nygma2004/growatt2mqtt/(threads)

Thread 1 (2022-01-17):

only one datapoint is in ioBroker

DraycD, 2022-01-17:
Hi,
first of all thank you for all your work.

i have the issue that in iobroker is only one datapoint were is all in, but not seperate points:
do you have any idea how it can send seperate?
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

nygma2004, 2022-01-25:
I designed it to send all the data into a single topic in JSON format, because it is much easier to process for me rather than having 30 messages all in separate topic. If you want that, you need to re-write the `ReadInputRegisters()` method. There is a section with a comment saying `Generate the modbus MQTT message`. As you can see I put all the data into a JSON there. You can break that up, and send each of them into a separate MQTT topic.
I hope that will be enough, as there will be a lot of MQTT communication done in that method. It may take too long time and the ESP may crash not having enough time to perform other housekeeping tasks.

SHODK, 2022-02-05:
Hi,
What a great project you have made here, I follow you video and think I made a correct setup, however I get Error: Invalid slave ID on the MQTT
My Growatt is smae as yours, MIN 3000TL-XE
I check the COM ID on Growatt it is set to 001
I try change it to 002 or 003 with the same change in Arduino sketch
I double check my wiring of Wemos D1 and TTl to RS-485 module, I have same 230V power supply as you show
No matter what I try it give me same error, do you have any idea where to look?

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

DraycD, 2022-03-04:
I split it now direct in iOBroker.
Is there a Json path in browser?
something like http://192.168.2.43/cm?cmnd=status%208

sorry i m a noob

AlexanderSch90, 2023-03-21:
Hey @DraycD , can you please share your Iobroker code (your javascript; your blockly) to split the json?

hendrikhoffmann, 2024-02-11:
I forked the project and changed the mqtt transfer from json to single data points.
I also added a Webinterface and API for controlling the inverter limits.
see https://github.com/hendrikhoffmann/growatt2mqtt

nygma2004, 2024-02-13:
> I forked the project and changed the mqtt transfer from json to single data points. I also added a Webinterface and API for controlling the inverter limits. see https://github.com/hendrikhoffmann/growatt2mqtt

Thanks for sharing this. Great job!

hoschiking, 2024-08-01:
@hendrikhoffmann
what´s the right way to compile your fork of the project?
the original project growatt2mqtt I compiled and it works fine.
I´m not able to do this.
I have the impression that some code is missing.
Do I have to replace parts of the original code with your code?
It woukd be finem if you would desribe it step by step.
Thank you in advance

hendrikhoffmann, 2024-08-03:
Thanks for letting me know & Fixed.
Either update the project or comment out
//#define useModulPower
in settings.h

hoschiking, 2024-08-08:
Your bugfix is working, now I´m able to compile it. thanks !!!
your fork would be absolutely perfect if the MQTT configuration was not implemented in the code, but could be configured via the Web API. Like with Wifi.
If the environment changes, you have to recompile every time.
It would be fine :-)

Thread 2 (2022-02-05):

Getting Error: Invalid slave ID

SHODK, 2022-02-05:
Hi,
What a great project you have made here, I follow you video and think I made a correct setup, however I get Error: Invalid slave ID on the MQTT
My Growatt is same as yours, MIN 3000TL-XE
I check the COM ID on Growatt it is set to 001
I try change it to 002 or 003 with the same change in Arduino sketch
I double check my wiring of Wemos D1 and TTl to RS-485 module, I have same 230V power supply as you show
No matter what I try it give me same error, do you have any idea where to look?

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

nygma2004, 2022-02-05:
OK, so this is interesting. In the log I can see messages saying that "Data MQTT Sent". So it is able to read data off the inverter from time to time. It is possible that the read rate is too quick for the inverter. That does not explain why it would send and invalid slave ID, but still. Can you change the UPDATE_MODBUS variable from 2 to for example 5 and test again?

SHODK, 2022-02-05:
Thanks for the quick reply, it did not help increasing it to 5 or 10, however I did find the fault and it was my own, when compiling the Arduino sketch a few days ago, it gave an error on "mqtt.setBufferSize(1024)" so I commented it out, it turnout that my PubSubClient library was a old version 2.7.0, upgrading to 2.8.0 it could now compile without error, uploaded program and everything works now.
Again, thanks for a great program and video

nygma2004, 2022-02-06:
Oh, wow, I did not know that the setBufferSize was only implemented in 2.8.0. Good catch. I needed this as the data payloads are very big.

unimatrixZxero, 2022-08-21:
Adding a data-point here. I had that error as well initially, I noticed that one of the connections to the RS485-TTL wasn't very good. Fixed the connection and the issue resolved itself.  Specifically it was the DE -> D5 connection ( RS485-TTL -> ESP32 D1 Mini)

no-Legend, 2023-07-27:
I'm facing the same problem with my MIC600, all the time I got that error.
Allready using the 2.8.0 version of PubSubClient and there is now warning during the compilation.

nygma2004, 2023-07-27:
@no-Legend sorry but to be exact, are you getting the error on compiling the sketch?
Can you paste in the error that you get?

Closed 2022-02-06.

Thread 3 (2022-03-09):

Max485 <----> ESP / IOs are not 5V tollerant

Stumpf74, 2022-03-09:
Hello,

I have a question about the hardware.
you use 5V for your circuit. The ESP generates the 3.3V for the core voltage from this. This means that you would actually need a level shifter between ESP and MAX.

Will it work without one?

Thanks

BR
Stumpf

nygma2004, 2022-03-09:
Yes it certainly works. To be honest I never realized that MAX is 5V. I copied the hardware from another project and used it in many different project, and never had any issues.

Stumpf74, 2022-03-10:
Okay then, I will try this!

Thanks for the project. My Growatt MIN 3600TL-XE I will report briefly on how it works.

Stumpf74, 2022-03-15:
Hello, so it works.

I use the USB connection as the power supply.
This gives me the data I need for my control system.

Thanks for your advance work.

Greetings

Closed 2022-03-15.

Thread 4 (2022-06-14):

Wifi does not connect

Alexbuehs, 2022-06-14:
I am a newcomer to the field, I flashed the ESP with the code via Arduino. I made the setting under Settings.h but unfortunately the ESP does not connect to the Wifi after flashing. Can you maybe help me and tell me where exactly I have to set what in the Settings.h tab?
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

nygma2004, 2022-06-14:
You need to change all the x-es to the actual values in your system: SSID, password, MQTT server IP address, userid and password.

Alexbuehs, 2022-06-14:
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

nygma2004, 2022-06-14:
You can leave it as it is. The ESP will just get a dynamic IP address, it will not impact how it works.

Alexbuehs, 2022-06-14:
First of all, thank you very much for your help. That's exactly how I did it and the esp was flashed without any problems but when I then open the serial monitor there is always WIFI Connecting .............. and that repeats itself again and again. If the esp is flashed, the blue LED also lights up permanently, is that correct?

nygma2004, 2022-06-14:
Yes, the blue is on until it connects to the wifi, and from that point it only flashes when reads the inverter. Can you screenshot the current settings.h file (obviously blurring out the passwords) and the full serial log? Maybe that will give me some ideas on what is going on.

Alexbuehs, 2022-06-14:
I will take a screenshot of settings.h tomorrow and post here. Thanks again for your help.

Alexbuehs, 2022-06-15:
Hey, I realised that the code is running. I deleted your code from the computer again. Then I re-downloaded your code again in Arduino opened the x-es replaced and flashed. The ESP now connects to the Wifi. Now I just have to see that I can do it with the broker. Do that with a raspberry and the iobroker but in the data point it only says true. Is there another way to even see if the esp receives data? I connected all this to a Growatt TL-X.

Alexbuehs, 2022-06-15:
And one more question. Does the Wifi Shine X Stick have to be unplugged?

nygma2004, 2022-06-15:
Check the serial debugger. If it is not able to read the inverter, you get some error messages (like No Response or similar). So if you see no error, the modbus is working.
I think the Shine X plugs into a different port, so you can leave it. I don't have that.

Alexbuehs, 2022-06-15:
How do I get the serial debugger via wifi? Or leave the esp connected to the pc and then via the serial monitor from Arduino?

nygma2004, 2022-06-16:
Yes, use it connected to the computer and user the serial monitor from Arduino IDE.

Closed 2022-06-16.

Thread 5 (2022-07-07):

MQTT data not received from inverter.

Flintebassen, 2022-07-07:
Hi.

Since this morning i only receive data on Growatt/status not on Growatt/data.
I have tried both the 1.2 and 1.3 code.

Maybe it's just my inverter, i dont know.
It have been running fine for 1 month, but stopped this morning.

MQTT explorer also only shows data from Growatt/status.

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

nygma2004, 2022-07-08:
The "Error: Response timed out" is an error message from the modbus communication. For some reason your ESP is no longer talking to the inverter over modbus. I am not sure what the issue can be. I recommend to check the wiring and the connection first. Maybe one of the wires somewhere got loose.
My second guess that the modbus module has died, but it never happened with me so that I think is less likely.
Nevertheless, please use the same firmware that was working before.

Flintebassen, 2022-07-08:
Hi, thank you for getting back to me.
I did not consider wiring because i get the data from Growatt/status fine.
I will check it anyway.

Flintebassen, 2022-07-08:
I have checked the wiring, all ok.
I will try and power down/up the inverter tomorrow.
The problem exist on any of the firmware. I only tried the newest one because the old one did not work anymore.

nygma2004, 2022-07-10:
I am not sure what to say. The client address of the inverter is 1, and I don't think it can even be changed (or how). So I really don't know why it is not communicating. Again, all I can think is that the TTL to RS485 module died.

Flintebassen, 2022-07-14:
You where right. The RS485 adapter was faulty. I replaced it with another brand, and it is working now. Sorry for the confusing.

Closed 2022-07-14.

Thread 7 (2022-08-14):

Publish Home Assistant auto-discovery sensors

That-Dude, 2022-08-14:
First of all I just want to say thank you for this project. I've got it working with my Growatt inverter and learned so much in the process.

I use Home Assistant and the trickiest part was figuring out how to import the values, I achieved this by adding MQTT sensors to my `configuration.yaml` but it's a hacky solution.

```
sensor:
- platform: mqtt
  name: 'Growatt Solarpower'
  state_topic: 'growatt/data'
  value_template: '{{ value_json.solarpower }}'
  unit_of_measurement: 'W'
  device_class: power

- platform: mqtt
  name: 'Growatt Enery Today'
  state_topic: 'growatt/data'
  value_template: '{{ value_json.energytoday }}'
  unit_of_measurement: 'kWh'
  device_class: energy
```

I was wondering if you might add the functionality to publish the sensors from your sketch into the `homeassistant/sensor/growatt' topic, as this would allow Home Assistant auto-discovery:

I borrowed this example from another solution:

```
Topic :homeassistant/sensor/inverter_1_pv_power/config

{"device":{"ids":["sa_inverter"],"mdl":"Growatt MIN/MIC","mf":"Growatt","name":"Growatt MIN/MIC"},"device_class":"power","name":"PV power","state_topic":"solar/inverter_1/pv_power/state","uniq_id":"inverter_1_pv_power","unit_of_measurement":"W"}
```

nygma2004, 2022-08-14:
Hmmm, I have seen these homeassisant topic in my MQTT server, but never really paid much attention to them. But it does not look too complicated. But it will be a hell of a large big configuration message considering the high number of fields. I am in a middle of a large project, but I have some tidy up work to do here, so I think I will come back to this somewhere during the fall and add the homeassistant part as well.

That-Dude, 2022-08-16:
ok that sounds great, I'm looking forward to seeing the results.

I'm super pleased with your sketch, it's been working flawlessly for a week now.

nikito7, 2022-09-13:
For large configurations yaml it's easier to manage

jtauscher, 2023-01-26:
> For large configurations yaml it's easier to manage.
>
> One advantage of discovery, it's create a device on HA

> For large configurations yaml it's easier to manage.
>
> One advantage of discovery, it's create a device on HA

Hi nikito7, can you please explain how it works? Do you maybe have an example yaml code?

nikito7, 2023-01-26:
https://github.com/nikito7/easyhan/blob/dev/growatt/pv1-discovery.txt

Thread 8 (2022-08-17):

Used housing?

no-Legend, 2022-08-17:
Can you tell us which housing you designed the pub for?

Cheers Robert

nygma2004, 2022-08-17:
Sorry, I don't get it. Pub?

unimatrixZxero, 2022-08-21:
I think the question is asking. "What housing did you use to put the PCB in?" Or, what's the housing you used to put the components in?

nygma2004, 2022-08-23:
I used a regular electrical box I could find in my local shop. This is one of the harder shell models. I cut an opening on the top and added a window with a piece of acrylic.
I think it was this: https://daniella.hu/sez-kotodoboz-s-box-216-sima-falu-120x80x50-id-sez1001081000
It is hard to find transparent top enclosures.

Closed 2023-03-05.

Thread 10 (2022-09-24):

esphome has an Growatt component which could use your enhancement

osos, 2022-09-24:
Just wanted to make you aware that esphome has a preliminary growatt component.

https://esphome.io/components/sensor/growatt_solar.html
https://github.com/esphome/esphome/tree/dev/esphome/components/growatt_solar

Maybe it would be even easier to maintain etc to enhance the esphome component with the communications you have made here.

I think that would be a good place to merge the project as that will make it easily availble to the arduino/home-assistant community.

nygma2004, 2022-09-25:
Well, it looks like ESPHome implemented the same what I did. To be honest, I don't see a point merging anything. If you are using home assistant just set up ESPHome and for pure MQTT one can use my project.

Closed 2023-03-05.

Thread 12 (2022-10-23):

Spf5000es?

Roadkill69, 2022-10-23:
Howzit man, nice project,

I have been trying to get an esp working with an spf5000es, the comm port is a usb type A which connects to the dongle. Check the thread below, others have managed to flash the dongle (which has an esp chip) and use with esphome.

Any ideas on how to get Comms with this from the usb A port and an esp32, possible wiring?

https://community.home-assistant.io/t/esphome-modbus-growatt-shinewifi-s/369171/51

nygma2004, 2022-10-23:
Well, SPF5000ES looks like a nice inverter. I like that it can also use lead acid batteries, not just Litium.
Anyway, within the thread they mention that the Shine Wifi dongle uses GPIO 1 and 3.
So in the settings.h you can define it here:
#define MAX485_RX       14        // D5, RO pin on the TTL to RS485 converter
#define MAX485_TX       12        // D6, DI pin on the TTL to RS485 converter
so instead of 14 and 12 it should be 1 and 3. I can never tell which one should be which so you have to try.

I also had a quick look at the documentation and it looks like you have an RJ45 plug and that is the modbus connection on that inverter. So you can use that as well.

Thread 16 (2023-01-28):

use  growatt2mqtt  on classic arduino

geimel, 2023-01-28:
Hi,
I've found your great project and will use a part of your code on a arduino nano, to display the data on a oled display.
Yesterday I've received my MIC 1500TL-X, I have connected the RS485A1 and B1 to an usb-rs485 convertert, I've send several requests (read input an holding register) but get absolutely no answer.
Is it possible to help me with an example complete modbius request message, so I can send this over a terminal an check the connection.
(the RS485A2 B2 port works well, here I can see the requests of the inverter to smartmeter after activating this, so I think the USB Converter works)
Thanks a lot
Richard

nygma2004, 2023-01-28:
OK, so you have connected the inverter with your laptop with a usb-rs485? What program do you use to read data? What do you mean that you get nothing?

geimel, 2023-01-29:
there is no response from the MIC when I send a query

nygma2004, 2023-01-29:
Well, it is hard to tell from here. Few obvious questions:
- MIC is running/powered?
- Did you set the communication to 9600 baud, 8, N, 1? Slave ID = 1? Did you pick the correct COM port?
- Try swapping the A and B wires
- The USB and serial is close to the inverter?
- You are reading input registers, right?
- You are reading a few, like address 0 quantity 5?

geimel, 2023-01-30:
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

All above = yes.
I think it is a hardware defect :-(

nygma2004, 2023-01-31:
That is also possible. It would be a good idea to test with another USB to RS485 adapter.

Thread 17 (2023-02-10):

Schematic

bennybubble, 2023-02-10:
Hi,

Can you publish the schematic diagram of the interconnects ?

Thans in advance!

nygma2004, 2023-02-10:
Sorry, which interconnects?

bennybubble, 2023-02-10:
Between Wemos / RS485 / LED

bennybubble, 2023-02-10:
Sri, just found them in settings.h ... :-)

Closed 2023-02-10.

Thread 22 (2023-03-18):

RS232 Viability

chromos33, 2023-03-18:
Let me preface this with saying I am an absolute beginner on arduino etc. (webdeveloper with some c# experience)

But would it be possible to adapt this library to use this over the usb connection on the MIC 600 TL-X or do I need the RS485 cable connection?

And with the RS485 would I use the COM port as I don't see a "Sys Com" port on the inverter.

As far as I can google the usb is apparently just an RS232 wrapper.

chromos33, 2023-03-18:
nvm figured it out by referencing https://github.com/Lyve1981/GrowattUsbModbus
just need to replace the conents of growattInterface.cpp growattIF::initGrowatt()
with
Serial.begin(115200);
  growattInterface.begin(SLAVE_ID , Serial);

  static growattIF* obj = this;

nygma2004, 2023-03-19:
Sorry the late response. I am glad you managed to figure it out, because honestly I would have no idea how to do this. Kudos.

Closed 2023-03-18.

Thread 24 (2023-04-03):

SOC data request

aherzer69, 2023-04-03:
Hello,
first at all...THANK YOU VERY MUCH TO CREATE SUCH A GREAT PROJECT!!!!
Now I am trying to implement additional data from "Growatt Inverter Modbus RTU Protocol":
https://www.photovoltaikforum.com/core/attachment/265072-pdfcoffee-com-growatt-inverter-modbus-rtu-protocolii-v120-english-pdf-free-pdf/
(I think this is the right protocol for my SPH4600 because values until "95" (tempboost) are ok)

To get the SOC I add to your "growattInterface.cpp":

`    if (setcounter == 15) {
      // Battery
      modbusdata.socinverter = growattInterface.getResponseBuffer(1014 - 960);
    }`

and below the section:

 `setcounter++;
    if (setcounter == 2) {
      setcounter = 0;
      // Generate the modbus MQTT message
      sprintf(json, "{", json);
      sprintf(json, "%s \"status\":%d,", json, modbusdata.status);
      sprintf(json, "%s \"socinverter\":%.1f,", json, modbusdata.socinverter);`

In "growattInterface.h" I added to section the "socinverter":
`    struct modbus_input_registers
    {
      int status;
      float solarpower, pv1voltage, pv1current, pv1power, pv2voltage, pv2current, pv2power, outputpower, gridfrequency, gridvoltage;
      float energytoday, energytotal, totalworktime, allphaseenergy, gridpowertolocalload, energyp3, pv1energytoday, pv1energytotal, pv2energytoday, pv2energytotal, opfullpower;
      float dischargepower, chargepower, socinverter, batsoc;
      float tempinverter, tempipm, tempboost;
      int ipf, realoppercent, deratingmode, faultcode, faultbitcode, warningbitcode;
    };`

As MQTT feedback I received a "0" :-(
("socinverter": 0)

Did I something wrong to define "setcounter"???

nygma2004, 2023-04-05:
OK, so you need to read all the way up to 15*45 registers to get the battery soc.
Your approach is correct, but I think you made a mistake here:
```
      setcounter++;
      if (setcounter==2) {
        setcounter = 0;
```
Here, this code resets the setcounter to 0 after 1. Because I only needed to read 2 sets of 45 registers. So for you, you need to allow the code to count all the way up to 16 sets to reset.
````
      setcounter++;
      if (setcounter==16) {
        setcounter = 0;
````
I think that should work. Please give it a try, I can obviously not test that.

Thread 25 (2023-04-07):

Use growatt2mqtt for evcc

aherzer69, 2023-04-07:
Hello,

I would like to use the data from growatt2mqtt for EVCC

EVCC propsed following for Growatt inverter:
([https://docs.evcc.io/docs/devices/meters](url))

`meters:
  - name: my_grid
    type: template
    template: growatt-hybrid
    usage: grid

    # RS485 via adapter (Modbus RTU)
    modbus: rs485serial
    id: 1
    device: /dev/ttyUSB0 # USB-RS485 Adapter Adresse
    baudrate: 9600 # Prüfe die Geräteeinstellungen, typische Werte sind 9600, 19200, 38400, 57600, 115200
    comset: "8N1" # Kommunikationsparameter für den Adapter

    # RS485 via TCP/IP (Modbus RTU)
    modbus: rs485tcpip
    id: 1
    host: 192.0.2.2 # Hostname
    port: 502 # Port

    # Modbus TCP
    modbus: tcpip
    id: 1
    host: 192.0.2.2 # Hostname
    port: 502 # Port`

Is it possible to implement here the growatt2mqtt data?

or

I found also an older generic format of evcc:

`meters:
  - name: my_solarlog
    type: custom
    power:
      source: calc
      add:
        - source: modbus
          uri: 192.168.0.77:502
          id: 1
          register:
            address: 3502
            type: input
            decode: uint32s
          scale: -1`

As I understood, this is refering directly to modbus data.?
But I don't know how to use.
Is the "uri" the IP of my Inverter or from D1-mini with growatt2mqtt?
"id" = ?
"address" = modbus id of Growatt protocol? ("1" for "Input power (high)", ...)

I am sure it is possible, but I was not able to solve.

nygma2004, 2023-04-07:
OK, after reading about this page for 15-20 minutes, it looks like this software can read modbus directly. Ideally you don't even need my converter at all. You can plug an RS485 to USB converter into the computer/SBC this software is running on and connect the A/B lines to Growatt directly. And it will read the data straight from the inverter. You can see Growatt examples in their page. Remember RS485 can travel few hundred meters without any problems.

Or you can get a modbus RS485 to TCP gateway, and use the TCP example. I would try either of these routes and it will be a direct communication between evcc and the inverter.

As far as I can see, these examples support some generic Growatt Hybrid inverter and TL-XH series, so if you have one of those it will work. But they don't seem to have a template for other models.

aherzer69, 2023-04-08:
Thank you very much for effort and quick reply!!!
I am very happy with your software! It is running since weeks w/o problems.
With your software I have robust values (just in time!) to use it for my Home Assistant activities.
If it is not possible to use the access of growatt2mqtt to evcc, I will try to use the mqtt data in evcc.

nygma2004, 2023-04-09:
I don't think it is possible. I have seen modbus client implementation for the ESP, but a modbus master.
The only option I can think about is a modbus RS485 to TCP gateway and through that evcc and homeassistant could read your inverter as well.

Thread 26 (2023-04-10):

WDT Timeout Issue

cwynd, 2023-04-10:
Congrats on a nice project!
I am trying to port the code to a ESP32C3 (I have a few, and I've used them in several other projects), and I've commented pretty much everything except the core functionality (no ArduinoOTA, no NeoPixel, no MQTT data send), just some `Serial.println()` debug messages for now.

I'm trying to talk to one (of a pair) of Growatt SPF3000TL inverters.
But if I flash the code (stripped down as above) I get "Guru Meditation Error: Core  0 panic'ed (Interrupt wdt timeout on CPU0)." (error repeated verbatim for future searches). I noticed you mentioned a WDT timeout in one of the videos, which got my attention, so hoping you may have some more insights.

My Timer ISR (same as your master code) calls `ReadHoldingRegisters()` in the ino, which invokes `growattInterface.ReadHoldingRegisters(json)` in growattInterface, of which the relevant entry point is:
```
uint8_t growattIF::ReadHoldingRegisters(char* json) {
  uint8_t result;
  ITimer0.stopTimer();
  result = growattInterface.readHoldingRegisters(setcounter * 64, 64); //<< WDT panic is occurring here
  // result = 0;
  ITimer0.restartTimer();
```
If I comment the `readHoldingRegisters` line and uncomment the `result=0;` it runs fine.
 Of course there could be several reasons something is timing out there - communications problem with the TTL to RS485 board (mine looks identical to the one you used), failed communications with the Growatt, etc, etc.

I would really like to drill down in to the `growattInterface.readHoldingRegisters(setcounter * 64, 64)` call to try and figure out in more detail exactly what is timing out, so I can narrow it down, but I'm lost in the overloading of `ReadHoldingRegisters` (either capitalized or not) in the ino, and also in the growattInterface class.
So a specific question: where do I find the code that `growattInterface.readHoldingRegisters(setcounter * 64, 64)` invokes? grep etc is not helping.

I really like the clean ISR approach to invoking the code, but I'm stuck trying to use it at the moment.
Any insights really appreciated!

cwynd, 2023-04-11:
Thanks, it's a good point, the `ITimer0.stopTimer()` in my code only stops that specific ISR from getting double triggered if it takes too long. But rereading your code, I see that you turned off the interrupt WDT itself. I may have to try that on the ESP32C3, but it may be problematical with other timing critical things going on.

Where's the source for the `growattInterface.readHoldingRegisters(setcounter * 64, 64)` method?
I must be missing something, I can't find it.

On a very rough guesstimate the Growatt modbus dialog must take something like 500mS (64 x 16 bit registers @ 9600, ignoring overhead), so we're looking for relatively a lot of time.

Thanks again

cwynd, 2023-04-13:
I've been able to get past the WDT timeout issue by refactoring the code as a couple of [Tasks](https://www.freertos.org/implementing-a-FreeRTOS-task.html) on top of the Espressif FreeRTOS core, and I'm using a queue to pass the json from a Growatt Modbus query task to an MQTT post task.

This seems fine so far, and solves the WDT timeout issue, without having to disable the WDT. These tasks run at a lower priority than core processes (WDT etc), and so can take as long as they need. This means though the Modbus code may get interrupted by the core intermittently, so a concern is that this may trip up the serial timing, though I have not seen evidence of that yet, and since it's only 9600 there's hope that it won't.
I believe all Espressif SoCs (ESP...) use their version of FreeRTOS under the hood, so this approach _might_ be applicable to the ESP8266 as well.

How did you figure out the `SLAVE_ID` of the Growatt?
I am now getting `Invalid SlaveID` back from the Modbus code, and with weak documentation struggling to figure out the valid slave ID, short of taking the time to brute force it.

nygma2004, 2023-04-14:
The default slave ID is 1. But you can change it on the screen. I checked the documentation, it does not mention "modbus" or "slave id" anywhere, but this is the closest setting I could find:
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

cwynd, 2023-04-14:
Thanks so much.
I added temporary `Serial.println()`'s for the slaveID that I query and the slave ID sent back from the Growatt in ModbusMaster, and I am getting a _changing_ ID back - on one one occasion I sent 1 and I actually got slaveID 1 back, but on every other occasion I've gotten 2, 3, etc.

So I'm now thinking that the serial comms is not working the way I think it's working for whatever reason (timing inside the FreeRTOS Task?).
I've ordered an RS485 to USB dongle, and I'll try talking to the Growatt using [mbpoll](https://github.com/epsilonrt/mbpoll) from my laptop. This should remove at least some of the uncertainty around new code, comms, etc. leaving only the Growatt talking to known code.

nygma2004, 2023-04-16:
That is very interesting. There is CRC check in the modbus communication, so if the serial data is off, the CRC check would fail and the code would give an invalid CRC error. But checking with mbpoll and a USB dongle is a good workaround to check what is wrong.

cwynd, 2023-04-17:
It's a good point about the CRC check. I've now had a chance to try the USB dongle, and interestingly I am getting almost identical behavior. So this says to me that at least the immediate problem is not in the code, it is somewhere else (although there are few other things to suspect!).

I do wonder whether 9600 is the correct speed - I know in the master code you commented "do not change", but I'm running out of things to suspect now.

Rather than load up this thread with posts not directly related to the subject code, I have posted a question [over here](https://www.reddit.com/r/SolarDIY/comments/12pskpc/growatt_spf3000tl_and_rs485_data/).
I won't close this thread yet, pending any learnings from the post linked above, which may help others with implementing the code.

nygma2004, 2023-04-19:
Thanks, weird. Please let me know if you find out the solution. I see no reason why Growatt would do it any other way, but is it possible that the communication is not Modbus? When I see RS485 I always assume Modbus, but it does not necessarily have to be (sorry did not read the entire documentation). Also try using different flow control, like not 8 bits, maybe change the stop bit and parity. And yes you can play around with the baud as well.

cwynd, 2023-04-19:
So I figured out the communications.

It seems this Growatt SPF3000TL inverter has to be cold-rebooted when the RS485 Modbus slave ID is updated, otherwise it looks like it _listens_ for the new address, but responds with the _old_ address in the header, resulting in the Modbus master seeing an invalid slave ID. My inverters are in a production setting already, and so I had avoided rebooting them until now.

Also, it was a good suggestion to look at flow control, stop bit, parity etc - I had assumed (my bad) that 8N1 was the default, but it is not the default for `mbpoll` and it looks like the CRC errors were caused by a serial protocol mismatch.

I've now got far enough that I have read registers back from my Tasks version of the project code and `Serial.println`-ed the json. So I am moving on to passing the json to the MQTT posting Task, and tidying everything up now.

Thanks again for helpful suggestions!

nygma2004, 2023-04-20:
Wonderful, I am glad that all this worked out. Never thought about the cold-boot issue, good catch.

cwynd, 2023-04-21:
Thanks. I was considering whether to generate a PR for this, but the problem is the ESP32 code ends up being pretty different (HardwareSerial, task-based code structure), and when I tried, I ended up adding many compiler switches, so I don't think it's helpful.
But having said that, suggestions welcome.

Closed 2023-04-19.

Thread 27 (2023-04-16):

Growatt MOD 6000TL3-X

Teppis88, 2023-04-16:
Have to say that this code works fine with this 6kw 3phase model. Only problem is that I can't get voltages from different phases.

Can I somehow scan all the messages that growat sends so I could check em if it sends them?

nygma2004, 2023-04-16:
Yes you can. To make your life easier, maybe you can get a RS485 to USB dongle and you can access modbus directly on your laptop. It is easier to change the modbus parameters in a modbus tester program like Modbus Poll than changing the code, compile and upload. Just like other voltages, the voltage is stored on 0.1V, so you should look for values in 2200-2500 range.

joe288, 2023-04-22:
You can query additional values   in the **growattInterface.cpp** in the **ReadInputRegisters()** function.
As an example you can see how **gridvoltage** is implemented.

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

I think the values   you should be interested in are in the area.
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

You have to test the value of the information that interests you.

Unfortunately, I only have the single-phase version and can't do it for you.

joe288, 2023-04-29:
see changes from here https://github.com/wroadd/growatt2mqtt_for3phases

Teppis88, 2023-05-01:
Thanks Joe288! That works :)

Closed 2023-05-01.

Thread 28 (2023-04-21):

Sending setMaxOutput to MQTT

sstolk90, 2023-04-21:
Hi,

I would like to try this setting to reduce the power of the inverter in case of a negative energyprice when my battery is full.
In MQTT Explorer I tried to send this:

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

What am I doing wrong?
What is the syntax for the MQTT message?
I can not find any documentation in the code.

nygma2004, 2023-04-21:
Let me add @joe288 as he added this functionality to my original code.

sstolk90, 2023-04-21:
Since when is this in the code?
Because I think it's not in mine...

joe288, 2023-04-22:
Hello,
the value is simply transferred in decimal.
From 1-100%.
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
You can also switch off the Growatt completely via setEnable.
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

sstolk90, 2023-04-22:
Like this:
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
I get not any confirmation and the Growatt is still producing more then the limit.
Is this implemented after 20 aug 2022?

joe288, 2023-04-22:
this was added to the master branch of nygma2004 on 10 December.
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

sstolk90, 2023-04-23:
Thanks! So it is not in my sketch yet and that's why it won't scale down when instructed to.
I cannot update the sketch since Arduino IDE is bugging me big time but that is not part of this issue.
I get lots of errors for a FastLED and a lot more of definitions from certain files he cannot find.

Issue can be closed and thanks for your help!

Closed 2023-04-23.

Thread 29 (2023-05-11):

my version

Performance20, 2023-05-11:
Hi,

I forked your software and made some changes. I saw your comments, if stabillity is no so good and OTA firmware update not working
- I migrated to platformio/VSC
- change the string handling which add control of the size of the used buffer (e.g. sprinf to snprintf), which avoid buffer overruns. And there was realy 1 value which was one letter to long for the used buffer. Also using the same buffer as input and output in sprinf funktion could work but the statement is here "behavior not defined". Therfore I changed it.
- Also I removed all this MQTT building code out of the timer funktion. I thing, interrupt routines should be short and fast as possible and not lead to cascading of interrupts
- I added one feature. Now it is possible to change the update times for sending the MQTT messages (original fix values in the code via #defines). Now changeable via MQTT messages and stored in the EEprom of the ESP.
- and some other smaller changes
- But I removed all this RGB led stuff

I have tested it with my Growatt, run fine, Firmware update via OTA works fine well.

Helge

nygma2004, 2023-05-14:
Hi Helge,

Thanks a lot for your work. I know I should really switch from the Arduino IDE to VSC. Everyone says that it is so much better. But I think what would be even more helpful for the community if I would add WifiManager, so I can offer a binary that can be easily flashed to an ESP and WifiManager can be used to configure the server and modbus settings.

I have to be honest, I don't quite understand the importance between sprinf and snprintf, but I will investigate and learn about this more.
Moving most of the code out of the timer callback is a good idea. I was concerned in the beginning that it will cause issues with watchdog timer or something, but since it ended up working, I did not bother to review it.
Setting the refresh interval via MQTT is also a nice feature, and the RGB if only secondary for the entire function of the code, so not important.

I will share you project on my main page.

Regards,
Csongor

Performance20, 2023-05-26:
Short update from my site:
I removed the hard coded Wifi credentials from the code and inplemented a captive portal by using ESPConnect lib.
If the ESP is not configured to Wifi, he starts in AP mode and provide such a web portal, where the SSID can be selected and passeword enterd. Credential will be stored in eeprom.

Regards

Helge

Diddlik, 2023-05-26:
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

Is it possible to move mqtt setup in web settings too?

Thread 31 (2023-05-26):

Smart Meter emulation ingtegration

Diddlik, 2023-05-26:
Hi guys, since begin the use of Growatt I have built myself a small USB dongle to read growatt (https://github.com/Diddlik/USB_Dongle_ESP8266_Max485).
Now I plan to install export limit as well. A good project is here: https://github.com/alessandromatera/SDM230-emulator-growatt-esp-mqtt

What I want to achieve is that I have a stick, an ESP, which is connected to two RS485 converters.
One is used to read Growatt (pin 3/4) and the other Converter would be connected to pin 7/8 to act as a smart meter.
Is it possible to combine the Code of alessandromatera and yours?

The development of hardware part seems to be an easy step, but software part imho not so easy...

nygma2004, 2023-05-30:
As long as Growatt and the smart meter use the same communication speed and settings (9600, 8, 1, N) and the two devices are set to different slave ID, it should work. I would reassign either Growatt or the smart meter from the default slave ID of 1 (I presume) to a different address. And you just need to read / write the smart meter and Growatt after each other. The current Growatt logic already has the SetMaxOutput implemented.

But looking at the alessandromatera code, it does not talk to a Modbus smart meter, but it uses a Shelly smart meter and reads the data over MQTT. So it is not exactly doing what you plan to implement.

Diddlik, 2023-05-30:
> As long as Growatt and the smart meter use the same communication speed and settings (9600, 8, 1, N) and the two devices are set to different slave ID, it should work. I would reassign either Growatt or the smart meter from the default slave ID of 1 (I presume) to a different address. And you just need to read / write the smart meter and Growatt after each other. The current Growatt logic already has the SetMaxOutput implemented.
>
> But looking at the alessandromatera code, it does not talk to a Modbus smart meter, but it uses a Shelly smart meter and reads the data over MQTT. So it is not exactly doing what you plan to implement.

I am a little afraid that SetMaxOutput write to EPPROM from the inverter, which is not good in due long term.
The connection with second RS485 as smart meter solves the problem, because inverter dynamically controls it by itself without writing it to flash every time. or have I thought wrong here?

nygma2004, 2023-05-31:
Possible, but I have no way of telling how the inverter works internally. But both sketches write to the modbus register, therefore I don't see how the SetMaxOutput in our code and the same modbus code in alessandromatera example would be any different.

Thread 32 (2023-06-05):

Growatt MIN 3600TL-XE ?

newegnaro, 2023-06-05:
Hello,
Thank you for sharing this project. I recently has a solar system installed with the above Growatt inverter and I'm trying to get basic data from it into Home Assistant (HA). I've tried some of the HA integrations that pull from the Growatt server but these suffer from being blocked. So I thought I might be able to pull the data from the Modbus registers.

Your project looks like it could work if I pull the data from MQTT, however the SYS-COM definitions in the manual for my inverter  differs from the one you show. (see following image of manual)
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
Do you think it might work ? which of the ports from sys-com should I use ?
Sorry for the simple questions, very much of this is new to me.

nygma2004, 2023-06-07:
I think the smart meter connection is used to connect a meter so the inverter can limit the production to match your consumption (not to sell electricity to the grid). So it is definitely not that one.
I think it should be a the Connect Min ShineBus connection.

newegnaro, 2023-06-07:
Thank you for your thoughts. I need to decide if I have the skill to solder up your project to try this way. OI have been prototyping via a breadboard and ESPhome... but no luck yet.

newegnaro, 2023-06-20:
Hello, thank you for pointing this out. This was the thread i was using for my breadboard example but no luck despite trying a few of the code samples. I might have to try the flashed standard dongle method. Which inverter do you have please ?

nygma2004, 2023-06-20:
I have a 6 year old 3000-TL, and I also have a MIN 3000 TL-XE and MIC 1500 TL-X. The MIN and MIC models have the same connector (as documented in this project), the older 3000-TL has an old style 9 pin D-SUB9 connector.

Thread 33 (2023-09-24):

is it possible to enable/disable and change export limits via modbus for mic type inverters

HenrikRolandHansen, 2023-09-24:
Is it possible to enable/disable and change export limits via modbus for mic type inverters. seams not possible ?

joe288, 2024-03-21:
Hi,
Yes, it is possible to control the inverter so that no electricity flows into the power grid.

You can use the setMaxOutput function to limit the percentage output of the inverter if too much current flows into the grid.
This is nothing other than what is done via the Growat's electricity meter interface.

I would like to integrate this function myself, but unfortunately I am not yet able to read the electricity meter.

Thread 34 (2023-11-13):

Used your code! Thanks! Reworked main as code seems to freeze

matthijsfh, 2023-11-13:
Sorry, no way to contact you directly except via a issue ticket ;-)
Thanks for reverse engineering the inverter. Works like a charm.

However the "main" code seems to freeze.

* I think  **while (!mqtt.connected())** is the root cause if the wifi is lost after the last wifi check. This code will never exit the loop, as the mqtt will not connect, because the wifi is lost.

* Added all relevant parameters to the wifi manager (when then saves them to flash). Having to re-compile to change mqtt server settings is not my preferred solution. I have had issues with this on another ESP project. After 3+ years a mod was needed, and it did not compile anymore due to "progress" in the development tools.

* Added jumper to force the wifimanager to show.

* Added a FAN to cool the inverter which uses the temperature from the electronics board inside the inverter to switch on/off.

Can send you my changes if you are interested.

Greetings Matthijs

nygma2004, 2023-11-14:
Hi Matthijs,

Oh, these are great changes. I am still using my much older version of the code before it got re-worked by Joe. Wifimanager is great, actually I should add it to more of my projects. This also means that we can also offer complied binaries to users which is much easier to flash than if you have to build it yourself.
Good catch on the mqtt.connected issue. I never noticed this problem, I shall look at my version if I had done something differently. A few months ago my laptop died and I have not installed the IDE on my new device (was not working on project recently).
The jumper for the wifimanager is also a good idea. These sequence issues are a real pain to find, mostly because you cannot think of all these cases until it happens. Nowadays I am batteling with some modbus issues between my Node-Red and PLC which all of sudden started happening a few days ago. No software changes, nothing.
Fan is also a great idea.
I am interested in your implementation. If you send it, can you also send me a photo how the jumpe and the fan connection is implemented. I will add them to the readme for others to use it as an example.

matthijsfh, 2023-11-14:
Hi,

I will share my code with you. Think I found your email somewhere ;-)
My growatt code is stored my private github with much more projects.

Did remove some of your features, because I did not want to damage my inverter by sending some commands to it.

Anyway, have a look and maybe you can use some features of it.

Greetings Matthijs

Thread 35 (2023-11-18):

"PV energy today" and PV energy total missmatch

Kletternaut, 2023-11-18:
Hi Csongor,
at first i want to thank you very much, for your work here and also on Youtube. I'm on of your subscriber and have to say, i have learned a ton from what you doing and explaining... in an age of >55 ;-) Thank you man!

So now, i want to inform you there is a register mismatch and failure in the code For MIC-TL-X.

I do not get total- or today-energy values in mosquitto or influx. I've checked the register with the [Growatt Inverter Modbus RTU Protocol V.1.2](https://github.com/nygma2004/growatt2mqtt/blob/main/Growatt%20PV%20Inverter%20Modbus%20RS485%20RTU%20Protocol%20v120.pdf) and it says on the very first page:

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

So, there is **no input** register type range (**04**)  **0 - 124** in the **MIC TL-X** devices, only **3000-3124** also **not even** the (04) 3125-3249 range like the manual says.

your code: growattinterface.cpp:

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

The Growatt RTU Protocol Description for MIC-TL-X input (04) registers says:

**3053** | Epv_total H | PV energy **total**
3054 | Epv_total L  | PV energy total
**3055** | Epv1_today H  | PV1 energy **today**
3056 | Epv1_today L  | PV1 energy today
**3057** | Epv1_total H  | PV1 energy **total**
3058 | Epv1_total L   | PV1 energy total

Could you maybe check and correct this?

Greetings from Karlsruhe/Germany
Tom

nygma2004, 2023-11-18:
Hi Tom,

I also have a MIC-TL-X and the code works just fine there. There is a naming convention in modbus that the input registers are always number from 3000 and the holding registers from 4000 (or the other way around, I can never remember). This is done so when you look at the number you can immediately tell if it is a holding or input register. But in all the modbus software I used and also in the arduino library, you provide the address from the base 3000 or 4000. So what is addres 3000 in the documentation, in the program that is zero.
As I said this code is reading my small MIC 750 and it is fine.

Kletternaut, 2023-11-18:
What you write makes perfect sense, but various totay and total values are still mixed up. Take a look above.
What irritates me now is that I can read out the total and today data via the 3049 with my own nodered flow (attachment) over an waveshare modbus-wlan converter. But not with this esp-script and your Grafana dashboard. All other data are coming in.
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

Kletternaut, 2023-11-18:
I have checked the mqtt-mousquitto log file. `{"fields":{"deratingmode":0,"energytoday":0,"energytotal":0.9,"faultbitcode":0,"faultcode":0,"gridfrequency":49.99,"gridvoltage":227.2,"ipf":20000,"opfullpowe
r":0,"outputpower":21.5,"pv1current":0.3,"pv1energytoday":0,"pv1energytotal":0.9,"pv1power":22.1,"pv1voltage":58,"pv2current":0,"pv2energytoday":0,"pv2energyt
otal":0,"pv2power":0,"pv2voltage":0,"realoppercent":0,"solarpower":22.1,"status":1,"tempboost":0,"tempinverter":26.5,"tempipm":26.5,"totalworktime":165833.5,"
warningbitcode":0},"name":"mqtt_consumer","tags":{"host":"raspberrypi","topic":"growatt600/data"},"timestamp":1700298901}
`
Any ideas?

Kletternaut, 2023-11-19:
Hi Csongor,
i have checked it now multiple times. I am very sorry, also because i know that you have much more knowledge of the matter than i do. I have to say your code is not using the correct registers for the TL-X Series, because you've used the wrong register list documentation.
>There is a naming convention in modbus that the input registers are always number from 3000 and the holding registers from 4000

I noticed this for some manufactures (i believe the Eastron SDM630/230) with 3000x (for holding) and 4000x (for input), but now after my review i know it has nothing to do with this. These in the docmantation described 3000-registers are the right, real and only ones that worked correctly. You can't use register 0001 from a other device alternatively to the 3001 and so on. It is different address with different values in it, even when you get some values out of it and even many of them seems to be the right ones.

The documenatation (site no: 48) says it very clear: The input register for TL-X begins at 3000-3124, (3125...  right after the heading information:
>**Use for TL-X and TL-XH**
and this means **do not start at site no: 33 with input register no: 0.** of an different device.  In many cases the register are kind identical, but a few are different and others do not even exists. If you use 0001 it will bemapped to 3001 or vice versa.

I say it again: there are no input-register 0-124 for MIC-TL-X described in the documentation.

One example (then i'm done here):
In growattInterface.cpp @line 82:

>modbusdata.pv1energytoday = ((growattInterface.getResponseBuffer(59) << 16) | growattInterface.getResponseBuffer(60)) * 0.1;

Here you want to get value of "energy PV1 of actual day", like it is described in input-register list no. 59, right? But instead it reads (with, or without the internal mapping function) the register 3059 | E**pv2**_today. There is no PV**2** in a MIC-TL-X. And that is the reason why i am getting no value.  I've found a few other mismatched addresses in your code. No question, it is a total mess what they have done in this documantation.

nygma2004, 2023-11-21:
OK, I see the problem. The issue is that it will be very difficult to make code changes without having the actual device and testing how it works. Also I am not really sure what is the best way of making the code work for the "old" devices and the MIC-TL-X as well. Maybe this new mapping is something they will roll out for all new models in the future?

Kletternaut, 2023-11-21:
i have you send an email

Thread 36 (2023-12-29):

Monitor multiple inverters? Multi-phase, parallel installation.

RoganDawes, 2023-12-29:
I am trying to help a friend monitor his inverters (5 x SPF5000TL HVM-P, arranged as 2 each in parallel on phase A and B, and 1 on phase C) and batteries (4 x Narada 48NPFC100). He has no ShineWifi dongles - apparently these inverters make use of the ShineWifi-F model, which talks RS232 over the USB D+ and D- lines of the USB-A connector.

I have been able to create an ESP32-based device with an SP3232 RS232 transceiver that can talk to one inverter via the USB-A connector. Now I am trying to figure out how best to communicate with the remaining inverters, and the batteries.

With the RS232 connection to a single inverter, and trying to brute force enumerate modbus slave addresses, I was able to find 1 (expected), and 17. I was wondering whether 17 would be the paralleled inverter, 17 == 16+1 or 0b1001, but the readings I got from address 17 were totally inconsistent with the readings from address 1. Lots of 65536 values. Anyone have any idea what might be at address 17?

I'm totally open to switching over to RS485 if it will make life easier in any way. That said, all I have read in the Growatt manuals has not provided any way of changing the modbus slave address from the default 1, which would mean that I would need a RS485 bus for each inverter regardless, to avoid conflict. In which case, since the RS232 transceiver chip I am using has two channels already, and the ESP32 can support up to 3 UARTs simultaneously, I could just use one ESP32 per phase to talk to two inverters, and add an RS485 transceiver to the C-phase ESP32 to talk to the batteries. That said, is it even necessary to query the paralleled inverter, should the readings not theoretically be the same as the primary?

Any other suggestions?

RoganDawes, 2023-12-29:
I did find a mostly unintelligible description of setting the RS485 address on the last page of this document: https://watts247.com/manuals/gw/GrowattModBusProtocol.pdf

> Knock the pv inverter to let the lcd display to the “COM Addr: xxx”, then double knock, if displays “Move”, you should another double knock, until it displays a address number, then you can give a single knock to change the address, this address will be remembered when the lcd backlight off.

Not sure what "knock"ing is in this context?

nygma2004, 2023-12-31:
You literally knock on the display on the unit to change the screen. It has been a long time since I did mine, but you can change a few things through the screen like language, internal clock and the modbus address. Probably there is a vibration sensor behind the screen. A simple finger tap does not always trigger it, but a knock like you knock on the door does.
And yes, with RS485 and modbus you should be able to read multiple devices with a single ESP. Just remember the wire the RS485 lines in series (one device after the other), and not in star shape. And yes you would read each device one-by-one in a loop.

RoganDawes, 2023-12-31:
Oh jeez! That's a super intuitive user interface! Thanks for the info, I'll try see if I can get it to do the necessary!

nygma2004, 2024-01-01:
Yeah I know. I am pretty sure there are robust solution nowadays to waterproof buttons or even use some sort of capacitive sensor. But anyway. Not that I am nocking a lot on this thing...

RoganDawes, 2024-01-14:
Seems like my friend's inverters are newer than the knockable ones. I do appear to have the modbus holding register that controls the inverter's slave address available in the documentation, so my plan is just to change that, and see what happens. If necessary, I will power cycle the inverter, as I have seen suggestions that it ends up responding to commands on the new address, but responding from the original address until after the powercycle!
For what it is worth, I queried the inverter serial number on slave address 17, and got the same serial number as on address 1, so it would appear to be an odd artifact. Thanks for the help. I will connect via RS485 if I am successful at changing the addresses.

Closed 2024-01-14.

Thread 37 (2024-03-17):

[Question] useModulPower outside the mqtt context

chromos33, 2024-03-17:
Hey probably best directed to @joe288 ,

I'm trying to use the useModulPower function standalone like plugging in the ESP board like an usb stick and have it rewrite the
Inverter Config.

Tried adding the code to the Setup method after initializing the Interface but it won't update the config in the Inverter. All I'm getting is either illegal function or response timeout. Is there some special sauce that makes this work in the mqtt request or am I just going crazy.

Currently using a static string for that looks the same when compared to the mqtt message but maybe some encoding difference?

like in the Growatt2mqtt_1p2s.ino (removed mqtt code)

```
void setup()
{
     //Other init code
    String message = "OA";
     growattInterface.initGrowatt();
     growattInterface.writeRegister(growattInterface.regOnOff, 0);
    delay(500);

    result = growattInterface.writeRegister(growattInterface.regModulPower, int(strtol(message.c_str(), NULL, 16)));
    delay(500);
    growattInterface.writeRegister(growattInterface.regOnOff, 1);
    delay(1500);

    if (result == growattInterface.Success) {
      holdingregisters = false;
    } else {
      //using WebSerial to send the result
    }
}
```
have also tried it in loop() (multiple execution prevented)

Help would be appreciated.

nygma2004, 2024-03-19:
I think the first issue here, that 0A to set the inverter to 1000W is not a string, but a hex value: 0x0A.
I never used this function myself, let me add @joe288 as he added this part of the code.
@joe288 just to recap, when you publish to the "SetModulePower" topic, you expected to pass the value as decimal and not at string like "0A" right?
Based on this, I think instead of
```
String message = "OA";
```
it should be:
```
uint16_t modulpower = 0x0A;
```
and further in the code, instead of
```
result = growattInterface.writeRegister(growattInterface.regModulPower, int(strtol(message.c_str(), NULL, 16)));
```
it should be:
```
result = growattInterface.writeRegister(growattInterface.regModulPower, modulepower);
```
Please wait until @joe288 confirms it.

joe288, 2024-03-21:
Hi,
@nygma2004 your change should produce the same result. In the implementation with MQTT it still has to be converted from string to integer. You can optimize this step with the variant of nygma2004.

the code should actually work.
you have to make sure that you first can switch the inverter on/off.
````
growattInterface.writeRegister(growattInterface.regOnOff, 0);    // switch off the inverter
growattInterface.writeRegister(growattInterface.regOnOff, 1);    // switch on the inverter
````
The configuration can only be changed when the inverter is switched off.

Of course it could also be that your inverter has a different timing than mine. I would test to increase the delays significantly to make sure that the commands have been processed completely.

I hope these tips help you to find the problem.

chromos33, 2024-03-22:
thanks for the help, am going to try that next.
Timing thing isn't/shouldn't be an issue as over mqtt it worked even useing R232 instead of what the repo is saying

chromos33, 2024-03-23:
Yeah that was it. thanks again.

Closed 2024-03-23.

Thread 38 (2024-03-28):

Changes in Libraries?

ubv-28n, 2024-03-28:
I had to add: PubSubClient and didn't find: SoftwareSerial ?

Growatt2mqtt_1p2s.ino
.
.
10 // - SoftwareSerial  (didn't find this?)
11 // - PubSubClient (had to install this one)

-  aside from this I was up and running for some hours.
- I didn't have the plug, so I made the pins out of paper clips and soldered it to the wiers.

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

BR Eirik - Norway

Thread 40 (2024-07-05):

"maxpower" setting?

matthias-bs, 2024-07-05:
Hi,

let's assume "modulPower" has been changed from "0006" to "000A" and ""maxoutputactivepp" from 100 to 80, resulting in:

``` JSON
{
    "enable": 1,
    "safetyfuncen": 25,
    "maxoutputactivepp": 80,
    "maxoutputreactivepp": 0,
    "maxpower": 600.0,
    "voltnormal": 100.0,
    "startvoltage": 50.0,
    "gridvoltlowlimit": 184.0,
    "gridvolthighlimit": 287.5,
    "gridfreqlowlimit": 47.5,
    "gridfreqhighlimit": 51.5,
    "gridvoltlowconnlimit": 197.8,
    "gridvolthighconnlimit": 250.7,
    "gridfreqlowconnlimit": 47.7,
    "gridfreqhighconnlimit": 50.0,
    "firmware": "GH1.0",
    "controlfirmware": "ZAAA",
    "serial": "",
    "modulPower": "000A"
}
```

Would you have to change "maxpower" from 600 to 800 as well to achieve a maximum grid power output of 800 VA?

Thanks in advance,
Matthias
```

nygma2004, 2024-07-08:
I did not change the maxpower settings on my inverters, so I am not sure. @joe288 can you please advice?

joe288, 2024-07-10:
Hello,
your settings look good.
I had a similar effect. Apparently it takes a while for the inverter to change the values.
What is the maximum output that the inverter has achieved in the last few days?

My settings look almost exactly the same.
````
{
  "enable": 1,
  "safetyfuncen": 509,
  "maxoutputactivepp": 100,
  "maxoutputreactivepp": 0,
  "maxpower": 1500,
  "voltnormal": 100,
  "startvoltage": 50,
  "gridvoltlowlimit": 184,
  "gridvolthighlimit": 287.5,
  "gridfreqlowlimit": 47.5,
  "gridfreqhighlimit": 51.5,
  "gridvoltlowconnlimit": 195.5,
  "gridvolthighconnlimit": 253,
  "gridfreqlowconnlimit": 47.7,
  "gridfreqhighconnlimit": 50.1,
  "firmware": "GH1.0",
  "controlfirmware": "ZAAa",
  "serial": "",
  "modulPower": "000F"
}
```

matthias-bs, 2024-07-10:
Hi,
yes, I can confirm that setting "modulPower" works as expected and that "maxpower" changes automatically afterwards.

Thanks @nygma2004 and @joe288 for the great project and for taking care of this issue!

Closed 2024-07-10.
