nygma2004/growatt2mqtt/Growatt2mqtt_1p2s.ino

// Growatt Solar Inverter to MQTT
// Repo: https://github.com/nygma2004/growatt2mqtt
// author: Csongor Varga, csongor.varga@gmail.com
// 1 Phase, 2 string inverter version such as MIN 3000 TL-XE, MIC 1500 TL-X

// Libraries:
// - FastLED by Daniel Garcia
// - ModbusMaster by Doc Walker
// - ArduinoOTA
// - SoftwareSerial
// Hardware:
// - Wemos D1 mini
// - RS485 to TTL converter: https://www.aliexpress.com/item/1005001621798947.html
// - To power from mains: Hi-Link 5V power supply (https://www.aliexpress.com/item/1005001484531375.html), fuseholder and 1A fuse, and varistor

#include <ESP8266WiFi.h>          // Wifi connection
#include <ESP8266WebServer.h>     // Web server for general HTTP response
#include <PubSubClient.h>         // MQTT support
#include <WiFiUdp.h>
#include <ArduinoOTA.h>
#include <FastLED.h>
#include "globals.h"
#include "settings.h"
#include "growattInterface.h"
#include "mqtt_discovery.h"

os_timer_t myTimer;
ESP8266WebServer server(80);
WiFiClient espClient;
PubSubClient mqtt(mqtt_server, 1883, 0, espClient);

CRGB leds[NUM_LEDS];
growattIF growattInterface(MAX485_RE_NEG, MAX485_DE, MAX485_RX, MAX485_TX);

#ifdef ZeroExport
#include "zeroExport.h"
zeroExport zeroExportReader(SmartMeterEndpoint, UPDATE_SMETER);
#endif

char settingsJson[1024];
char dataJson[1024];
uint8_t outputPercent = 100;

void ReadInputRegisters() {
  char topic[80];

  leds[0] = CRGB::Yellow;
  FastLED.show();
  uint8_t result;

  digitalWrite(STATUS_LED, 0);

  result = growattInterface.ReadInputRegisters(dataJson);
  if (result == growattInterface.Success) {
    leds[0] = CRGB::Green;
    FastLED.show();
    lastRGB = millis();
    ledoff = true;

#ifdef DEBUG_SERIAL
    Serial.println(result);
#endif
    sprintf(topic, "%s/data", topicRoot);
    mqtt.publish(topic, dataJson);
    Serial.println("Data MQTT sent");

  } else if (result != growattInterface.Continue) {
    leds[0] = CRGB::Red;
    FastLED.show();
    lastRGB = millis();
    ledoff = true;

    Serial.print(F("Error: "));
    String message = growattInterface.sendModbusError(result);
    Serial.println(message);
    char topic[80];
    sprintf(topic, "%s/error", topicRoot);
    mqtt.publish(topic, message.c_str());
    delay(5);
  }
  digitalWrite(STATUS_LED, 1);
}

void ReadHoldingRegisters() {
  char topic[80];

  leds[0] = CRGB::Yellow;
  FastLED.show();
  uint8_t result;

  digitalWrite(STATUS_LED, 0);
  result = growattInterface.ReadHoldingRegisters(settingsJson);
  if (result == growattInterface.Success)   {
    leds[0] = CRGB::Green;
    FastLED.show();
    lastRGB = millis();
    ledoff = true;

#ifdef DEBUG_SERIAL
    Serial.println(settingsJson);
#endif
    sprintf(topic, "%s/settings", topicRoot);
    mqtt.publish(topic, settingsJson);
    Serial.println("Setting MQTT sent");
    // Set the flag to true not to read the holding registers again
    holdingregisters = true;

  } else if (result != growattInterface.Continue) {
    leds[0] = CRGB::Red;
    FastLED.show();
    lastRGB = millis();
    ledoff = true;

    Serial.print(F("Error: "));
    String message = growattInterface.sendModbusError(result);
    Serial.println(message);
    char topic[80];
    sprintf(topic, "%s/error", topicRoot);
    mqtt.publish(topic, message.c_str());
    delay(5);
  }
  digitalWrite(STATUS_LED, 1);
}

// This is the 1 second timer callback function
void timerCallback(void *pArg) {
  seconds++;

  // Query the modbus device
  if (seconds % UPDATE_MODBUS == 0) {
    //ReadInputRegisters();
    if (!holdingregisters) {
      // Read the holding registers
      ReadHoldingRegisters();
    } else {
      // Read the input registers
      ReadInputRegisters();
    }
  }

  // Send RSSI and uptime status
  if (seconds % UPDATE_STATUS == 0) {
    // Send MQTT update
    if (mqtt_server != "") {
      char topic[80];
      char value[300];
      sprintf(value, "{\"rssi\": %d, \"uptime\": %d, \"ssid\": \"%s\", \"ip\": \"%d.%d.%d.%d\", \"clientid\":\"%s\", \"version\":\"%s\"}", WiFi.RSSI(), uptime, WiFi.SSID().c_str(), WiFi.localIP()[0], WiFi.localIP()[1], WiFi.localIP()[2], WiFi.localIP()[3], newclientid, buildversion);
      sprintf(topic, "%s/%s", topicRoot, "status");
      mqtt.publish(topic, value);
      Serial.println(F("MQTT status sent"));
    }
  }
}

// MQTT reconnect logic
void reconnect() {
  //String mytopic;
  // Loop until we're reconnected
  while (!mqtt.connected()) {
    Serial.print("Attempting MQTT connection...");
    byte mac[6];                     // the MAC address of your Wifi shield
    WiFi.macAddress(mac);
    sprintf(newclientid, "%s-%02x%02x%02x", clientID, mac[2], mac[1], mac[0]);
    Serial.print(F("Client ID: "));
    Serial.println(newclientid);
    // Attempt to connect
    char topic[80];
    sprintf(topic, "%s/%s", topicRoot, "connection");
    if (mqtt.connect(newclientid, mqtt_user, mqtt_password, topic, 1, true, "offline")) { //last will
      Serial.println(F("connected"));
      // ... and resubscribe
      mqtt.publish(topic, "online", true);
      sprintf(topic, "%s/write/#", topicRoot);
      mqtt.subscribe(topic);
      
      // Publish Home Assistant MQTT discovery messages
      #ifdef HA_ENABLE_DISCOVERY
        publishHADiscovery(mqtt, clientID, newclientid, topicRoot, buildversion);
      #endif
    } else {
      Serial.print(F("failed, rc="));
      Serial.print(mqtt.state());
      Serial.println(F(" try again in 5 seconds"));
      // Wait 5 seconds before retrying
      delay(5000);
    }
  }
}

void setup() {
  FastLED.addLeds<LED_TYPE, RGBLED_PIN, COLOR_ORDER>(leds, NUM_LEDS).setCorrection( TypicalSMD5050 );
  FastLED.setBrightness( BRIGHTNESS );
  leds[0] = CRGB::Pink;
  FastLED.show();

  Serial.begin(SERIAL_RATE);
  Serial.println(F("\nGrowatt Solar Inverter to MQTT Gateway"));
  // Init outputs, RS485 in receive mode
  pinMode(STATUS_LED, OUTPUT);

  // Initialize some variables
  uptime = 0;
  seconds = 0;
  leds[0] = CRGB::Pink;
  FastLED.show();

  // Connect to Wifi
  Serial.print(F("Connecting to Wifi"));
  WiFi.mode(WIFI_STA);

#ifdef FIXEDIP
  // Configures static IP address
  if (!WiFi.config(local_IP, gateway, subnet, primaryDNS, secondaryDNS)) {
    Serial.println("STA Failed to configure");
  }
#endif

  WiFi.begin(ssid, password);
  while (WiFi.status() != WL_CONNECTED) {
    delay(500);
    Serial.print(F("."));
    seconds++;
    if (seconds > 180) {
      // reboot the ESP if cannot connect to wifi
      ESP.restart();
    }
  }
  seconds = 0;
  Serial.println("");
  Serial.println(F("Connected to wifi network"));
  Serial.print(F("IP address: "));
  Serial.println(WiFi.localIP());
  Serial.print(F("Signal [RSSI]: "));
  Serial.println(WiFi.RSSI());

  // Set up the Modbus line
  growattInterface.initGrowatt();
  Serial.println("Modbus connection is set up");

  // Create the 1 second timer interrupt
  os_timer_setfn(&myTimer, timerCallback, NULL);
  os_timer_arm(&myTimer, 1000, true);

  server.on("/", []() {                       // Dummy page
    server.send(200, "text/plain", "Growatt Solar Inverter to MQTT Gateway");
  });
  server.begin();
  Serial.println(F("HTTP server started"));

  // Set up the MQTT server connection
  if (mqtt_server != "") {
    mqtt.setServer(mqtt_server, 1883);
    mqtt.setBufferSize(1024);
    mqtt.setCallback(callback);
  }

  // Port defaults to 8266
  // ArduinoOTA.setPort(8266);

  // Hostname defaults to esp8266-[ChipID]
  byte mac[6];                     // the MAC address of your Wifi shield
  WiFi.macAddress(mac);
  char value[80];
  sprintf(value, "%s-%02x%02x%02x", clientID, mac[2], mac[1], mac[0]);
  ArduinoOTA.setHostname(value);

  // No authentication by default
  // ArduinoOTA.setPassword((const char *)"123");

  ArduinoOTA.onStart([]() {
    os_timer_disarm(&myTimer);
    Serial.println("Start");
  });
  ArduinoOTA.onEnd([]() {
    Serial.println("\nEnd");
    os_timer_arm(&myTimer, 1000, true);
  });
  ArduinoOTA.onProgress([](unsigned int progress, unsigned int total) {
    Serial.printf("Progress: %u%%\r", (progress / (total / 100)));
  });
  ArduinoOTA.onError([](ota_error_t error) {
    Serial.printf("Error[%u]: ", error);
    if (error == OTA_AUTH_ERROR) Serial.println("Auth Failed");
    else if (error == OTA_BEGIN_ERROR) Serial.println("Begin Failed");
    else if (error == OTA_CONNECT_ERROR) Serial.println("Connect Failed");
    else if (error == OTA_RECEIVE_ERROR) Serial.println("Receive Failed");
    else if (error == OTA_END_ERROR) Serial.println("End Failed");
  });
  ArduinoOTA.begin();

  leds[0] = CRGB::Black;
  FastLED.show();
}

void callback(char* topic, byte* payload, unsigned int length) {
  // Convert the incoming byte array to a string

  int i = 0;
  uint8_t result;
  for (i = 0; i < length; i++) {        // each char to upper
    payload[i] = toupper(payload[i]);
  }
  payload[length] = '\0';               // Null terminator used to terminate the char array
  String message = (char*)payload;

  char expectedTopic[40];

  sprintf(expectedTopic, "%s/write/getSettings", topicRoot);
  if (strcmp(expectedTopic, topic) == 0) {
    if (strcmp((char *)payload, "ON") == 0) {
      holdingregisters = false;
    }
  }

  sprintf(expectedTopic, "%s/write/setEnable", topicRoot);
  if (strcmp(expectedTopic, topic) == 0) {
    char json[50];
    char topic[80];

    if (strcmp((char *)payload, "ON") == 0) {
      growattInterface.writeRegister(growattInterface.regOnOff, 1);
      delay(5);
      sprintf(json, "{ \"enable\":%d}", growattInterface.readRegister(growattInterface.regOnOff));
      sprintf(topic, "%s/settings", topicRoot);
      mqtt.publish(topic, json);
    } else if (strcmp((char *)payload, "OFF") == 0) {
      growattInterface.writeRegister(growattInterface.regOnOff, 0);
      delay(5);
      sprintf(json, "{ \"enable\":%d}", growattInterface.readRegister(growattInterface.regOnOff));
      sprintf(topic, "%s/settings", topicRoot);
      mqtt.publish(topic, json);
    }
  }

  sprintf(expectedTopic, "%s/write/setMaxOutput", topicRoot);
  if (strcmp(expectedTopic, topic) == 0) {
    char json[50];
    char topic[80];

    result = growattInterface.writeRegister(growattInterface.regMaxOutputActive, message.toInt());
    if (result == growattInterface.Success) {
      holdingregisters = false;
    } else {
      sprintf(json, "last trasmition has faild with: %s", growattInterface.sendModbusError(result).c_str());
      sprintf(topic, "%s/error", topicRoot);
      mqtt.publish(topic, json);
    }
  }

  sprintf(expectedTopic, "%s/write/setTrakerModel", topicRoot);
  if (strcmp(expectedTopic, topic) == 0) {
    char json[50];
    char topic[80];

    result = growattInterface.writeRegister(growattInterface.regTrakerModel, message.toInt());
    if (result == growattInterface.Success) {
      holdingregisters = false;
    } else {
      sprintf(json, "last trasmition has faild with: %s", growattInterface.sendModbusError(result).c_str());
      sprintf(topic, "%s/error", topicRoot);
      mqtt.publish(topic, json);
    }
  }

  sprintf(expectedTopic, "%s/write/setStartVoltage", topicRoot);
  if (strcmp(expectedTopic, topic) == 0) {
    char json[50];
    char topic[80];

    result = growattInterface.writeRegister(growattInterface.regStartVoltage, (message.toInt() * 10)); //*10 transmit with one digit after decimal place
    if (result == growattInterface.Success) {
      holdingregisters = false;
    } else {
      sprintf(json, "last trasmition has faild with: %s", growattInterface.sendModbusError(result).c_str());
      sprintf(topic, "%s/error", topicRoot);
      mqtt.publish(topic, json);
    }
  }

#ifdef useModulPower
  sprintf(expectedTopic, "%s/write/setModulPower", topicRoot);
  if (strcmp(expectedTopic, topic) == 0) {
    char json[50];
    char topic[80];

    growattInterface.writeRegister(growattInterface.regOnOff, 0);
    delay(500);

    result = growattInterface.writeRegister(growattInterface.regModulPower, int(strtol(message.c_str(), NULL, 16)));
    delay(500);
    growattInterface.writeRegister(growattInterface.regOnOff, 1);
    delay(1500);

    if (result == growattInterface.Success) {
      holdingregisters = false;
    } else {
      sprintf(json, "last trasmition has faild with: %s", growattInterface.sendModbusError(result).c_str());
      sprintf(topic, "%s/error", topicRoot);
      mqtt.publish(topic, json);
    }
  }
#endif

#ifdef DEBUG_SERIAL
  Serial.print(F("Message arrived on topic: ["));
  Serial.print(topic);
  Serial.print(F("], "));
  Serial.println(message);
#endif
}

void loop() {
  // Handle HTTP server requests
  server.handleClient();
  ArduinoOTA.handle();

  // Handle SmartMeterReader (non-blocking, performs HTTP request if interval elapsed)
#ifdef ZeroExport
  uint8_t out;
  zeroExportReader.handle(dataJson,settingsJson,&out);
  if(out != outputPercent ){
    outputPercent = out;
    uint8_t result = growattInterface.writeRegister(growattInterface.regMaxOutputActive, outputPercent);
    if (result == growattInterface.Success)
      holdingregisters = false;
  }
#endif

  // Handle MQTT connection/reconnection
  if (mqtt_server != "") {
    if (!mqtt.connected()) {
      reconnect();
    }
    mqtt.loop();
  }

  // Uptime calculation
  if (millis() - lastTick >= 60000) {
    lastTick = millis();
    uptime++;
  }

  if (millis() - lastWifiCheck >= WIFICHECK) {
    // reconnect to the wifi network if connection is lost
    if (WiFi.status() != WL_CONNECTED) {
      Serial.println("Reconnecting to wifi...");
      WiFi.reconnect();
    }
    lastWifiCheck = millis();
  }

  if (ledoff && (millis() - lastRGB >= RGBSTATUSDELAY)) {
    ledoff = false;
    leds[0] = CRGB::Black;
    FastLED.show();
  }
}
