nygma2004/growatt2mqtt/globals.h

char msg[50];
String mqttStat = "";
unsigned long lastTick, uptime, seconds, lastWifiCheck, lastRGB;
bool ledoff = false;
bool holdingregisters = false;
char newclientid[80];
char buildversion[12]="v1.2.0p2s";
