nygma2004/growatt2mqtt/(commit log)

2021-12-11 Adding fixed IP option, and also fixing OTA problem
    [Growatt2mqtt_1p2s.ino, settings.h]
2022-06-27 Node-Red flow
2023-03-03 add modulPower, its the power Coding from Inverter
